UNIT-Electronics-MX/unit_devlab_tcan1051hvd_can_transceiver_module/tools/product-reference/chapters/06-mechanical.md

## 6 Mechanical Information

The nominal board outline is **29.83 mm × 25.40 mm**. The drawing below also
identifies the 3 mm mounting holes and principal spacing dimensions. All values
are in millimeters.



Use the released mechanical drawing or a physical sample when designing mating
enclosures or production fixtures; the rendered image is not a 1:1 fabrication
template.

### **6.1 Board Views** {.section-page}

| Top | Bottom |
|---|---|
|  |  |
