UNIT-Electronics-MX/unit_devlab_tcan1051hvd_can_transceiver_module/tools/product-reference/chapters/02-ratings.md

## 2 Ratings and Electrical Characteristics

### **2.1 Recommended Operating Conditions** {.section-page}

| Symbol | Description | Min | Typ | Max | Unit |
|---|---|---:|---:|---:|---|
| VIN | Module input voltage | 3.3 | — | 5.0 | V |
| VCC | TCAN1051HVD bus supply | 4.5 | 5.0 | 5.5 | V |
| VIO | Selected I/O supply | 2.8 | 3.3 / 5.0 | 5.5 | V |
| VOUT(5V) | TPS61023 regulated output, nominal | — | 5.0 | — | V |
| VOUT(3V3) | AP2112K regulated output, nominal | — | 3.3 | — | V |
| IO(RXD) | Recommended CRX output-current range | −2 | — | 2 | mA |
| TA | TCAN1051HVD operating free-air temperature | −55 | — | 125 | °C |
| CAN FD | Supported data rate for TCAN1051HVD | — | — | 2 | Mbps |

VIN represents the recommended module input voltage. VCC, VIO,
I/O current, temperature, and CAN FD values are TCAN1051HVD
specifications. The 1 Mbps limit of the ESP32-H2/P4 example is a
controller limit, not a transceiver limit.

The 5 V and 3.3 V rails are generated by the onboard TPS61023
boost converter and AP2112K-3.3 linear regulator, respectively.

The complete assembled module has not been independently
qualified over the full IC temperature range.

### **2.2 Selected Transceiver Characteristics** {.section-page}

Unless otherwise noted, the following characteristics apply
to the TCAN1051HVD transceiver.

| Symbol | Description | Min | Typ | Max | Unit |
|---|---|---:|---:|---:|---|
| VIH | CTX high-level input voltage | 0.7 × VIO | — | — | V |
| VIL | CTX low-level input voltage | — | — | 0.3 × VIO | V |
| VOH | CRX high-level output voltage at −2 mA | 0.8 × VIO | — | — | V |
| VOL | CRX low-level output voltage at 2 mA | — | — | 0.2 × VIO | V |
| VO(DOM), CANH | Dominant CANH output voltage | 2.75 | — | 4.5 | V |
| VO(DOM), CANL | Dominant CANL output voltage | 0.5 | — | 2.25 | V |
| VOD(DOM) | Dominant differential output, 50–65 Ω load | 1.5 | — | 3.0 | V |
| VCM | Receiver common-mode range | −30 | — | 30 | V |
| tPROP(LOOP) | Total loop delay | — | 100 / 110 | 160 / 175 | ns |

### **2.3 Power Regulation Characteristics** {.section-page}

The module integrates a TPS61023 boost converter and an
AP2112K-3.3 low-dropout linear regulator.

#### TPS61023 — 5 V Boost Converter

| Symbol | Description | Min | Typ | Max | Unit |
|---|---|---:|---:|---:|---|
| VIN(IC) | Converter operating input voltage | 0.5 | — | 5.5 | V |
| VSTART | Converter startup input voltage | — | — | 1.8 | V |
| VOUT | Adjustable output voltage range | 2.2 | — | 5.5 | V |
| VOUT(MOD) | Configured module output voltage | — | 5.0 | — | V |
| fSW | Switching frequency, VIN > 1.5 V | — | 1.0 | — | MHz |
| ILIM | Valley switch current limit, typical | — | 1 | — | A |

The TPS61023 generates the regulated 5 V rail from VIN.

The converter current-limit specification refers to the
internal switching current and must not be interpreted
as the available module output current.

The maximum external load on the 5 V rail has not been
independently characterized.

#### AP2112K-3.3 — 3.3 V Linear Regulator

| Symbol | Description | Min | Typ | Max | Unit |
|---|---|---:|---:|---:|---|
| VIN(LDO) | Regulator input voltage, nominal | — | 5.0 | — | V |
| VOUT | Fixed regulated output voltage, nominal | — | 3.3 | — | V |
| IOUT | Rated regulator output-current capability | — | — | 600 | mA |
| VDROP | Dropout voltage | TBD | TBD | TBD | mV |
| TA | Regulator operating temperature | TBD | — | TBD | °C |

The AP2112K-3.3 generates the module's 3.3 V rail from
the regulated 5 V supply.

The 600 mA rating represents the regulator IC capability,
not the guaranteed external current available from the
assembled module.

Available output current depends on regulator thermal
dissipation, PCB layout, input voltage, and total module
power consumption.

Dropout voltage and operating-temperature limits require
confirmation against the exact AP2112K manufacturer datasheet.

### **2.4 Absolute Maximum Ratings** {.section-page}

Absolute maximum ratings are stress limits, not normal
operating conditions.

#### TCAN1051HVD — CAN Transceiver

| Symbol | Description | Min | Max | Unit |
|---|---|---:|---:|---|
| VCC | TCAN1051HVD 5 V supply | −0.3 | 7 | V |
| VIO | TCAN1051HVD I/O supply | −0.3 | 7 | V |
| VBUS | CANH or CANL, H-suffix device | −70 | 70 | V |
| VDIFF | CANH-to-CANL differential voltage, H-suffix device | −70 | 70 | V |
| IO(RXD) | CRX output current | −8 | 8 | mA |
| TJ | IC junction temperature | −55 | 150 | °C |
| TSTG | IC storage temperature | −65 | 150 | °C |

The ±70 V bus-fault rating applies only to the specified
CAN bus pins and must not be applied to VIN, CTX, CRX,
EN, VIO, 3V3, or 5V.

#### Power Regulators

The TPS61023 and AP2112K-3.3 have independent absolute
maximum ratings defined by their respective manufacturers.

Their absolute maximum input, output, and temperature
ratings must not be interpreted as the operating limits
of the complete UE0085 module.

### **2.5 Module Power and Thermal Considerations** {.section-page}

The module uses the following power architecture:

- VIN supplies the TPS61023 boost converter.
- TPS61023 generates the regulated 5 V rail.
- AP2112K-3.3 generates the 3.3 V rail from 5 V.
- TCAN1051HVD operates from the regulated 5 V supply.
- VIO selects either the 3.3 V or 5 V logic rail.
- Both regulated rails are accessible through the module headers.

The AP2112K power dissipation can be estimated as:

P_D ≈ (VIN(LDO) − VOUT) × IOUT

At a 5 V regulator input and 3.3 V output, the voltage
difference is approximately 1.7 V.

The available external current on the 3.3 V and 5 V rails
has not been independently qualified.

Do not exceed the thermal, electrical, or current limits
of any individual component.
