UNIT-Electronics-MX/unit_devlab_tcan1051hvd_can_transceiver_module/tools/product-reference/chapters/08-references.md

## 8 Reference Documentation

| Reference | Link |
|---|---|
| Product repository | [UNIT-Electronics-MX/unit_devlab_tcan1051hvd_can_transceiver_module](https://github.com/UNIT-Electronics-MX/unit_devlab_tcan1051hvd_can_transceiver_module) |
| Arduino library | [UNIT-Electronics-MX/unit_devlab_tcan1051hvd_library](https://github.com/UNIT-Electronics-MX/unit_devlab_tcan1051hvd_library) |
| Product Wiki | [UNIT Electronics Wiki — UE0085](https://wiki.uelectronics.com/wiki/unit_devlab_tcan1051hvd_can_transceiver_module) |
| TCAN1051HV datasheet | [SLLSES8E](https://www.ti.com/lit/ds/symlink/tcan1051hv.pdf) |
| ESP32-H2 datasheet | [ESP32-H2 Series](https://documentation.espressif.com/esp32-h2_datasheet_en.html) |
| ESP32-P4 datasheet | [ESP32-P4 Series](https://documentation.espressif.com/esp32-p4_datasheet_en.html) |
| ISO 11898-2 overview | Refer to ISO 11898-2:2016 for the high-speed CAN physical layer |

The released schematic, manufacturer datasheets,
and hardware resources are available in the product
repository under `hardware/` and
`hardware/resources/datasheet/`.

The UNIT Electronics Wiki provides additional
product information and integration references.
