UNIT-Electronics-MX/unit_devlab_tcan1051hvd_can_transceiver_module/docs/hardware/unit_schematic_v_1_0_ue0085_TCAN1051HVD.pdf

H1 H2

R4

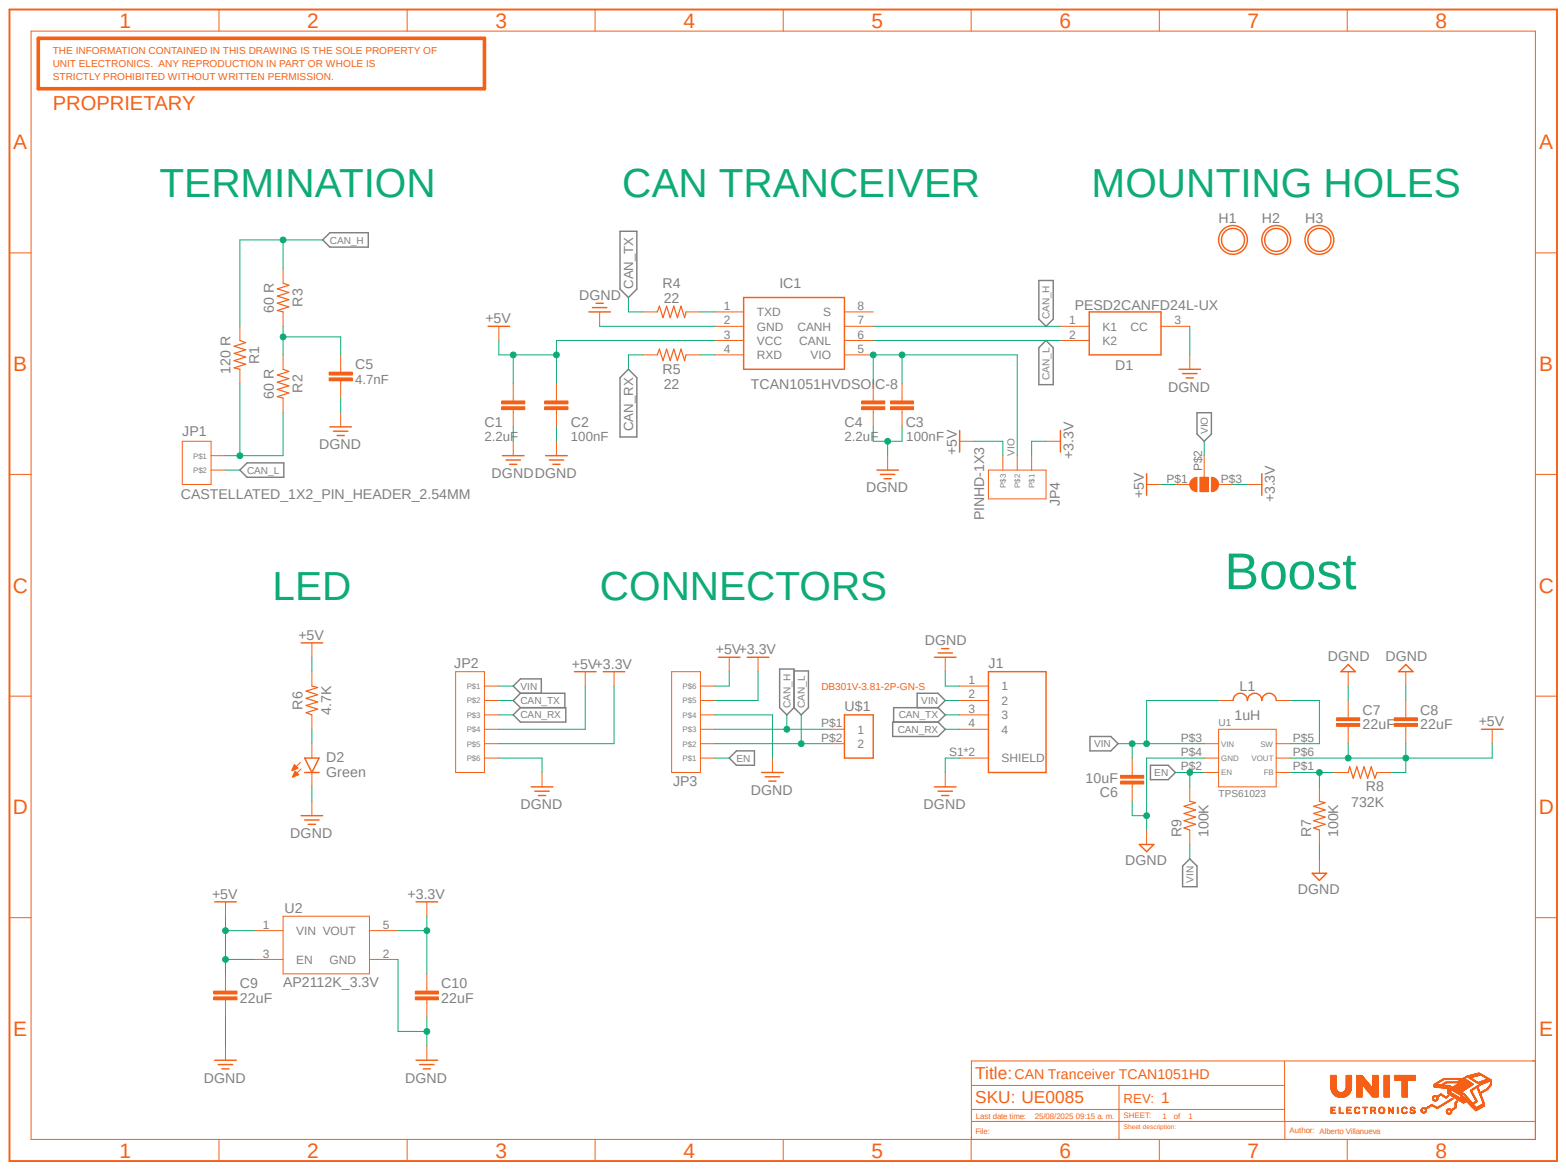
[picture p10: page 1]

THE INFORMATION CONTAINED IN THIS DRAWING IS THE SOLE PROPERTY OF UNIT ELECTRONICS. ANY REPRODUCTION IN PART OR WHOLE IS

STRICTLY PROHIBITED WITHOUT WRITTEN PERMISSION. PROPRIETARY

CAN Tranceiver TCAN1051HD | Author:

SKU: Last date time: 1 Alberto Villanueva UE0085 | REV: SHEET: Sheet description: of File:
