UNIT-Electronics-MX/unit_devlab_tcan1051hvd_can_transceiver_module/software/examples/basic_rx.ino

/***************************************************************
 * @file    CAN_Receiver.ino
 * @author  Jonathan Mejorado Lopez
 * @brief   Minimal CAN receiver example for the DevLab TCAN1051HVD
 *
 * Features
 * - CAN init on default pins
 * - Receive a message with a counter value
 *
 * Notes
 * - The CAN transceiver must be properly connected
 * - The message will be sent every second
 *
 * Wiring (ESP32 P4 Probe default CAN)
 * - TX   -> GPIO20
 * - RX   -> GPIO21
 * - VIN  -> regulated 3V3 (if the host supply has enough capacity)
 * - GND  -> GND
 * - Set the UE0085 VIO selector to 3V3; connect CTX/CRX to TX/RX
 ***************************************************************/

#include <DevLab_TCAN1051HVD.h>

#define CAN_TX_PIN GPIO_NUM_20
#define CAN_RX_PIN GPIO_NUM_21

DevLab_TCAN1051HVD can(CAN_TX_PIN, CAN_RX_PIN);

void setup() {

    Serial.begin(115200);
    delay(1000);

    if (!can.begin()) {

        Serial.println("Error al iniciar CAN");
        while (true)
            delay(1000);
    }

    Serial.println("CAN iniciado correctamente");
    Serial.println("Esperando mensajes...");
}

void loop() {

    TCAN1051_Frame frame;

    if (can.receive(frame, 100)) {

        Serial.print("ID: 0x");
        Serial.println(frame.id, HEX);

        Serial.print("Cantidad de bytes: ");
        Serial.println(frame.length);

        if (frame.length > 0) {
            
            Serial.print("Dato recibido: ");
            Serial.println(frame.data[0]);
        }

        Serial.println();
    }
}
