UNIT-Electronics-MX/unit_devlab_tcan1051hvd_can_transceiver_module/(commit log)

2026-10-16 docs(UE0085): update board accessories and electrical specifications
2026-10-16 docs(UE0085): reorganize Section 1 and update board documentation
2026-10-16 docs(UE0085): update board operation and CAN communication examples
    Improve product documentation, Arduino TX/RX examples, hardware setup instructions, and communication verification guidance.
2026-10-16 docs(UE0085): clarify CAN FD and ESP32 TWAI limits
    Distinguish the 2 Mbps transceiver capability from the 1 Mbps Classic CAN limit of the ESP32-H2 and ESP32-P4 examples. Update product references and remove transceiver vendor naming from prose.
2026-10-16 docs(UE0085): simplify board assemblies table
    Remove the Source status column from section 1.3 of the product reference source.
2026-10-19 Update product reference contents and add schematic preview
