UNIT-Electronics-MX/unit_devlab_tcan1051hvd_can_transceiver_module/(notices)

Notices in the files:
software/README.md:
License: MIT
